Lysandr/chipwhisperer/hardware/capture/chipwhisperer-lite/pcb - guillotined/bom/CWLITEBOM.xlsx

Sheet: Change Log
Rev | Date | Line Ref | Qty Change | Note
 |  |  |  | Original Release
 | 12-24-2014 | 22 | 5 --> 4 | R37 Value Changed to 1 Ohm
 | 12-24-2014 | 20 | 3 --> 4 | R37 Value Changed to 1 Ohm
 | 12-25-2014 | 33 | 4-->5 | R77 Added (Switched Vtarget)
 | 12-25-2014 | 40 | 1-->2 | T3 Added (Switched Vtarget)
 | 12-25-2014 | 44 | 8-->7 | D8 Removed (LED Removed)
 | 12-25-2014 | 29 | 8-->7 | D8 Removed (LED Removed)
 | 01-07-2015 | 44 | 7-->4 | D4 Changed to Green, D6+D9 Changed to Blue
 | 01-07-2015 | 42 | 3-->2 | D4 Changed to Green, D7+D8 was here by error
 | 01-07-2015 | 45 | 0-->2 | D6+D9 Changed to Blue
-03 | 01-15-2015 | 39 | 1-->2 | Addition of T4
-03 | 01-15-2015 | 20 | 4-->5 | Addition of R78
-03 | 01-15-2015 | 27 | 5-->6 | Addition of R43
-04 | 03-31-2015 | 13 | 53-->52 | Deletion of C117
-04 | 03-31-2015 | 23 | 4-->3 | Deletion of R32
-04 | 03-31-2015 | 25 | 8-->9 | Addition of R79
-04 | 03-31-2015 | 13 | 52-->53 | Addition of C123 (NOTE: net effect is no change on qty of 100nF/0402)
-04 | 03-31-2015 | 29 | 7-->6 | Deletion of R38
-04 | 03-31-2015 | 53 | No Change | Change of U12 PN (XMEGA128A4U --> XMEGA128D3-AU)
-04A | 04-14-2015 | 16 | 3-->4 | Fix error in quantity
-04A | 04-14-2015 | 32 | No Change | Fix part # for resistor
-04A | 04-14-2015 | 45 | No Change | Fix missing part #
-04A | 04-14-2015 | 16 | No Change | Remove C0G dielectric spec, add part #
-04A | 04-26-2015 | 1 | 2-->3 | Fix error in quantity
-04A | 04-26-2015 | 10 | 4-->6 | Fix error in quantity
-04A | 04-28-2015 | 27 | No Change | Change R60 --> R61
-04A | 04-28-2015 | 52 | No Change | Switch Xilinx FPGA to reflect 'commercial' temp grade is OK
-04B | 04-29-2015 | 53 | No Change | Fix XMEGA Part No from D3 to D4

Sheet: BOM List
Line Ref | Qty | Open-ADC XREF Line # | Refs | Description | Value | Other Specs | Package | MPN | Digikey Part No. | Digikey Price (USD) | Extended
Capacitors, 0805
1 | 3 |  | C34, C35, C36 | Capacitor | 22uF | 10V, 20% Tol | 0805C | LMK212BJ226MG-T | 587-1958-1-ND | 0.2438 | 0.7314
2 | 1 |  | C37 | Capacitor | 47uF | 6.3V, 20% Tol | 0805C | CL21A476MQCLRNC | 1276-2420-1-ND | 0.3575 | 0.3575
Capacitors, 0603
3 | 1 |  | C33 | Capacitor | 10pF | C0G/NP0, 5% | 0603C | CL10C100JB8NCNC | 1276-2154-1-ND | 0.0138 | 0.0138
4 | 1 | 10 | C69 | Capacitor | 22pF | C0G/NP0, 5% | 0603C | CL10C220JB8NCNC | 1276-2227-1-ND | 0.0138 | 0.0138
5 | 2 |  | C87, C88 | Capacitor | 100pF | C0G/NP0, 5% | 0603C | CL10C101JB8NCNC | 1276-2163-1-ND | 0.0121 | 0.0242
6 | 3 |  | C46, C47, C104 | Capacitor | 10nF | 10V+, 10% Tol | 0603C | GRM188R71H103KA01D | 490-1512-1-ND | 0.0087 | 0.0261
7 | 1 | 7 | C67 | Capacitor | 18nF | 10V+, 10% Tol | 0603C | GRM188R71H183KA01D | 490-1516-1-ND | 0.0087 | 0.0087
8 | 11 | 4 | C41, C43, C44, C48, C49, C68, C85, C86, C106, C108, C109 | Capacitor | 100n | 10V+, 10% Tol | 0603C | GRM188R71H104KA93D | 490-1519-1-ND | 0.0182 | 0.2002
9 | 13 |  | C60, C61, C62, C63, C107, C45, C105, C78, C82, C89, C90, C110, C111 | Ceramic Capacitor | 1uF | 10V, 10% Tol | 0603C | GRM188R61A105KA61D | 490-1543-1-ND | 0.019 | 0.247
10 | 6 |  | C5, C26, C27, C38, C39, C40 | Capacitor | 2u2 | 10V, 10% Tol | 0603C | GRM188R61A225KE34D | 490-1545-1-ND | 0.0551 | 0.3306
11 | 3 |  | C3, C6, C7 | Capacitor | 4u7 | 6.3V, 10% Tol | 0603C | GRM188R60J475KE19D | 490-3297-1-ND | 0.038 | 0.114
12 | 4 |  | C42, C91, C95, C103 | Capacitor | 10uF | 10V, 10% Tol | 0603C | GRM188R61A106KE69D | 490-10474-1-ND | 0.21 | 0.84
Capacitors, 0402
13 | 53 | 1 | C4, C8, C9, C10, C11, C12, C13, C14, C15, C16, C17, C18, C19, C20, C21, C22, C23, C24, C25, C28, C29, C30, C31, C32, C52, C53, C54, C55, C56, C57, C58, C59, C64, C65, C66, C70, C71, C73, C75, C77, C79, C80, C81, C83, C92, C93, C94, C96, C98, C100, C113, C114, C123 | Capacitor | 100nF | 10V+, 10% Tol | 0402C | GRM155R61A104KA01D | 490-1318-1-ND | 0.0055 | 0.2915
14 | 2 |  | C50, C51 | Capacitor | 18pF | C0G Dielectric, 5% Tol | 0402C | C1005C0G1H180J050BA | 445-1238-1-ND | 0.011 | 0.022
15 | 3 | 2 | C72, C74, C76 | Ceramic Capacitor | 1nF | 10V+, 10% Tol | 0402C | C1005X7R1E102K050BA | 445-4924-1-ND | 0.011 | 0.033
16 | 4 | 5 | C84, C97, C99, C112 | Capacitor | 10n | 10V+, 5% tol | 0402C |  | 1276-1496-1-ND |  | 0
17 | 2 |  | C101, C102 | Capacitor | 220n | 6.3V+, 10% Tol | 0402C | LMK105BJ224KV-F | 587-1228-1-ND | 0.0248 | 0.0496
Resistors, 0805
18 | 2 |  | R66, R76 | Resistor | 49R9 |  | 0805 |  | RHM49.9AECT-ND | 0.052 | 0.104
19 | 0
Resistors, 0603
20 | 5 |  | R15, R62, R59, R37, R78 | Resistor | 1R | 1% | 0603R | MCR03ERTFL1R00 | RHM1570CT-ND | 0.0125 | 0.0625
21 | 2 | 17 | R46, R47 | Resistor | 33R | 0.50% | 0603R | RR0816Q-330-D | RR08Q33DCT-ND | 0.0381 | 0.0762
22 | 4 |  | R27, R28, R35, R36 | Resistor | 39R | 1% | 0603R | MCR03ERTF39R0 | RHM39CFCT-ND | 0.0047 | 0.0188
23 | 3 | 21 | R54, R67, R72 | Resistor | 100R | 1% | 0603R | MCR03ERTF1000 | RHM100CFCT-ND | 0.0047 | 0.0141
24 | 1 | 23 | R44 | Resistor | 274R | 0.50% | 0603R | RR0816P-2740-D-43A | RR08P274DCT-ND | 0.0381 | 0.0381
25 | 9 | 19 | R3, R7, R56, R63, R57, R58, R74, R75, R79 | Resistor | 1k | 1% | 0603R | MCR03ERTF1001 | RHM1.00KCFCT-ND | 0.0047 | 0.0423
26 | 4 | 24 | R23, R55, R52, R53 | Resistor | 2k | 1% | 0603R | MCR03ERTF2001 | RHM2.00KCFCT-ND | 0.0047 | 0.0188
27 | 6 | 20 | R13, R45, R61, R64, R65, R43 | Resistor | 10k | 1% | 0603R | MCR03ERTF1002 | RHM10.0KCFCT-ND | 0.0047 | 0.0282
Resistors, 0402
28 | 4 |  | R1, R5, R6, R14 | Resistor | 1R | 1% | 0402R |  | RHM1.00CDCT-ND | 0.0052 | 0.0208
29 | 6 |  | R2, R10, R39, R40, R41, R42 | Resistor | 330R | 1% | 0402R |  | RHM330CDCT-ND | 0.0052 | 0.0312
30 | 6 |  | R16, R48, R49, R50, R51, R68 | Resistor | 1k | 1% | 0402R |  | RHM1.00KCDCT-ND | 0.0052 | 0.0312
31 | 3 |  | R24, R26, R30 | Resistor | 1.5k | 1% | 0402R |  | RHM1.50KCDCT-ND | 0.0052 | 0.0156
32 | 2 |  | R25, R29 | Resistor | 6.81k | 1% | 0402R |  | 1276-4099-1-ND | 0.0052 | 0.0104
33 | 5 |  | R9, R11, R12, R69, R77 | Resistor | 10k | 1% | 0402R |  | RHM10.0KCDCT-ND | 0.0052 | 0.026
34 | 1 |  | R33 | Resistor | 47k | 1% | 0402R |  | RHM47.0KCDCT-ND | 0.0052 | 0.0052
35 | 1 |  | R34 | Resistor | 68k | 1% | 0402R |  | RHM68KCDCT-ND | 0.0052 | 0.0052
36 | 6 |  | R17, R18, R19, R20, R21, R31 | Resistor | 100k | 1% | 0402R |  | RHM100KCDCT-ND | 0.0052 | 0.0312
Diodes, Transistors
37 | 1 | 35 | D1 | Dual Diode | BAV99-7F |  | SOT-23 | BAV99-7-F | BAV99-FDICT-ND | 0.0927 | 0.0927
38 | 1 |  | U8 | N-Channel MOSFET | IRF7807ZTRPBF |  | SO08 | IRF7807ZTRPBF | IRF7807ZPBFCT-ND | 0.4607 | 0.4607
39 | 2 |  | T2,T4 | N-Channel MOSFET | IRLML2502 |  | SOT-23 | IRLML2502TRPBF | IRLML2502PBFCT-ND | 0.1441 | 0.2882
40 | 2 |  | T1,T3 | P-Channel MOSFET | IRLML6402TRPBF |  | SOT-23 | IRLML6402TRPBF | IRLML6402PBFCT-ND | 0.1333 | 0.2666
41 | 1 |  | U6 | ESD Protection Diode | PRTR5V0U2AX |  | SOT143B | PRTR5V0U2AX,215 | 568-7445-1-ND | 0.3634 | 0.3634
LEDs, 0603
42 | 2 |  | D4, LED9 | Green LED |  |  | LED-0603 | APT1608CGCK | 754-1116-1-ND | 0.1346 | 0.2692
43 | 0 |  |  | Yellow LED |  |  | LED-0603 |  |  |  | 0
44 | 4 |  | D2, D5, D7, LED10 | Red LED |  |  | LED-0603 | APT1608SURCK | 754-1123-1-ND | 0.1228 | 0.4912
45 | 2 |  | D6, D9 | Blue LED |  |  | LED-0603 | APT1608QBC/D | 754-1434-2-ND |  | 0
Inductors, Ferrite Bead
46 | 1 |  | L1 | Inductor | 10uH/100mA |  | 0603 |  | 535-12537-1-ND | 0.2925 | 0.2925
47 | 1 | 16 | L11 | Inductor | 120nH |  | 0603 |  | HK1005R12J-T | 0.0175 | 0.0175
48 | 5 | ? | L5, L7, L8, L9, L10 | Ferrite bead | 1k/500mA |  | 0603 |  | 587-1739-1-ND | 0.0508 | 0.254
49 | 2 |  | L4, L6 | Ferrite bead | 600R/1A |  | 0603 |  | 732-1593-1-ND | 0.1725 | 0.345
50 | 2 |  | L2, L3 | Shielded Inductor, Power | 3.3uH |  | VLS3015 | SRN3015-3R3M | SRN3015-3R3MCT-ND | 0.36 | 0.72 | SUB: VLS3015ET-3R3M
Crystals
51 | 1 |  | Q1 | Crystal | 12.0000MHz |  | 3.2 x 2.5mm | ABM8G-12.000MHZ-4Y-T3 | 535-10901-1-ND | 0.54 | 0.54
IC's
52 | 1 |  | U2 | Xilinx FPGA | 6SLX9TQG144 | Must be -3, NOT -2 | TQ144 | XC6SLX9-3TQG144C | 122-1748-ND | 19.82 | 19.82
53 | 1 |  | U12 | XMEGA Microcontroller | XMEGA128D4-AU |  | TQFP44 | XMEGA128D4-AU | ATXMEGA128D4-AURCT-ND | 3.51 | 3.51
54 | 1 |  | U1 | SAM3S Microcontroller | ATSAM3U2CA-AU |  | QFP50P1600X1600X160-100N | ATSAM3U2CA-AU | ATSAM3U2CA-AU-ND | 4.6531 | 4.6531
55 | 1 | 31 | U3 | Analog Devices VGA | AD8331 |  | QSOP20 | AD8331ARQZ | AD8331ARQZ-R7CT-ND | 9.0606 | 9.0606
56 | 1 | 30 | U4 | Analog Devices ADC | AD9215BRUZ |  | TSSOP28 | AD9215BRUZ-105 | AD9215BRUZ-105-ND | 12.2579 | 12.2579
57 | 1 | 32 | U10 | LDO Regulator, 3.0V | LP3985IM5-3.0 |  | SOT23-5 | LP3985IM5X-3.0/NOPB | LP3985IM5X-3.0/NOPBCT-ND | 0.4253 | 0.4253
58 | 1 |  | U7 | LDO Regulator, 3.3V | TC1262-3.3VDBTR |  | SOT223 | TC1262-3.3VDBTR | TC1262-3.3VDBCT-ND | 0.39 | 0.39
59 | 1 |  | U5 | Switching Regulator | LTC3419EMS |  | MSOP10 | LTC3419EMS#PBF | LTC3419EMS#PBF-ND | 2.29 | 2.29
Connectors
60 | 1 |  | J8 | Micro-USB jack, through-hole | MICRO-USB-5P-ZX62D-B-5P8 |  | B-SMD-5P-TH | ZX62D-B-5P8 | H11610CT-ND | 0.9133 | 0.9133
 |  |  |  |  |  |  |  |  |  |  | 61.6044
