Lysandr/chipwhisperer/hardware/capture/chipwhisperer-lite/pcb - guillotined/eagle/cw-lite-main.brd

## EAGLE design hardware/capture/chipwhisperer-lite/pcb - guillotined/eagle/cw-lite-main.brd (2020-10-10)

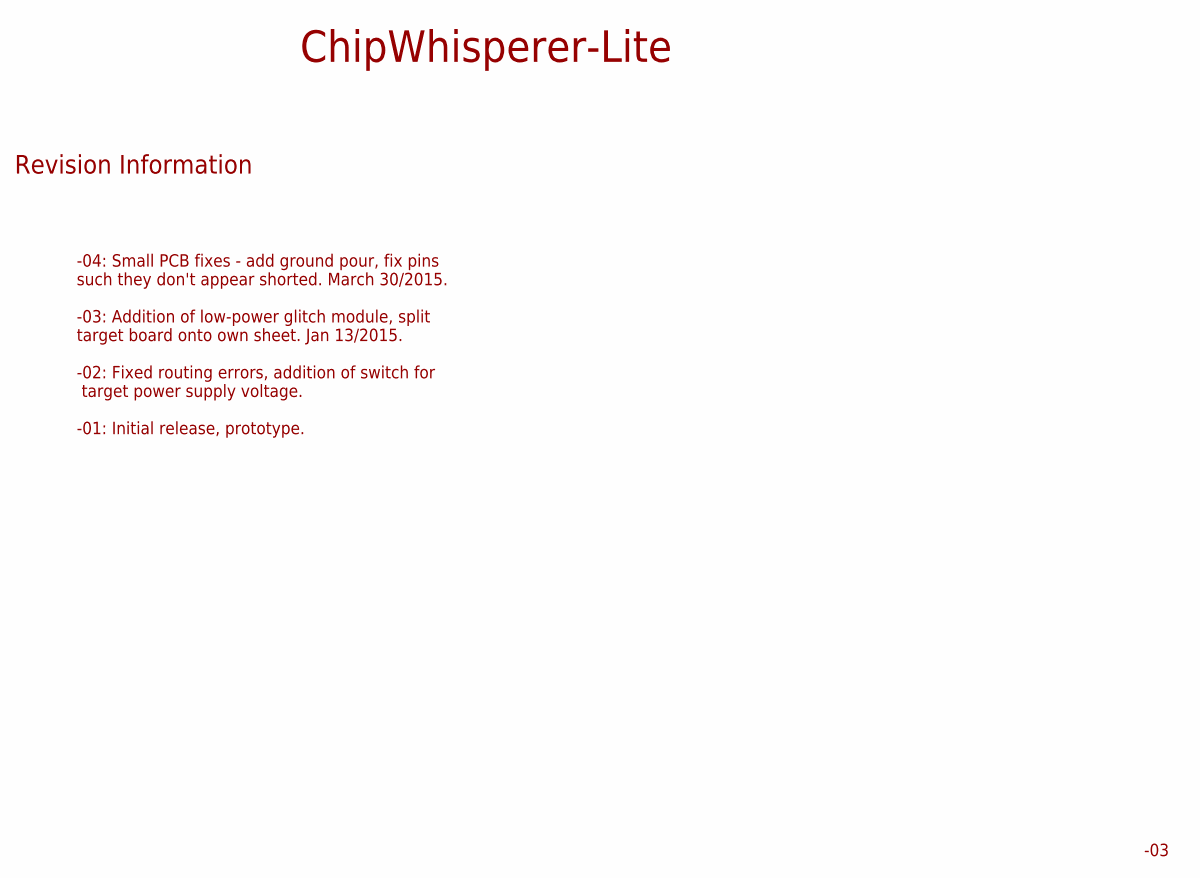
[picture p1: schematic cw-lite-main.sch, sheet 1]

Notes on the sheet:
-04: Small PCB fixes - add ground pour, fix pins such they don't appear shorted. March 30/2015. -03: Addition of low-power glitch module, split target board onto own sheet. Jan 13/2015. -02: Fixed routing errors, addition of switch for target power supply voltage. -01: Initial release, prototype.
ChipWhisperer-Lite
Revision Information

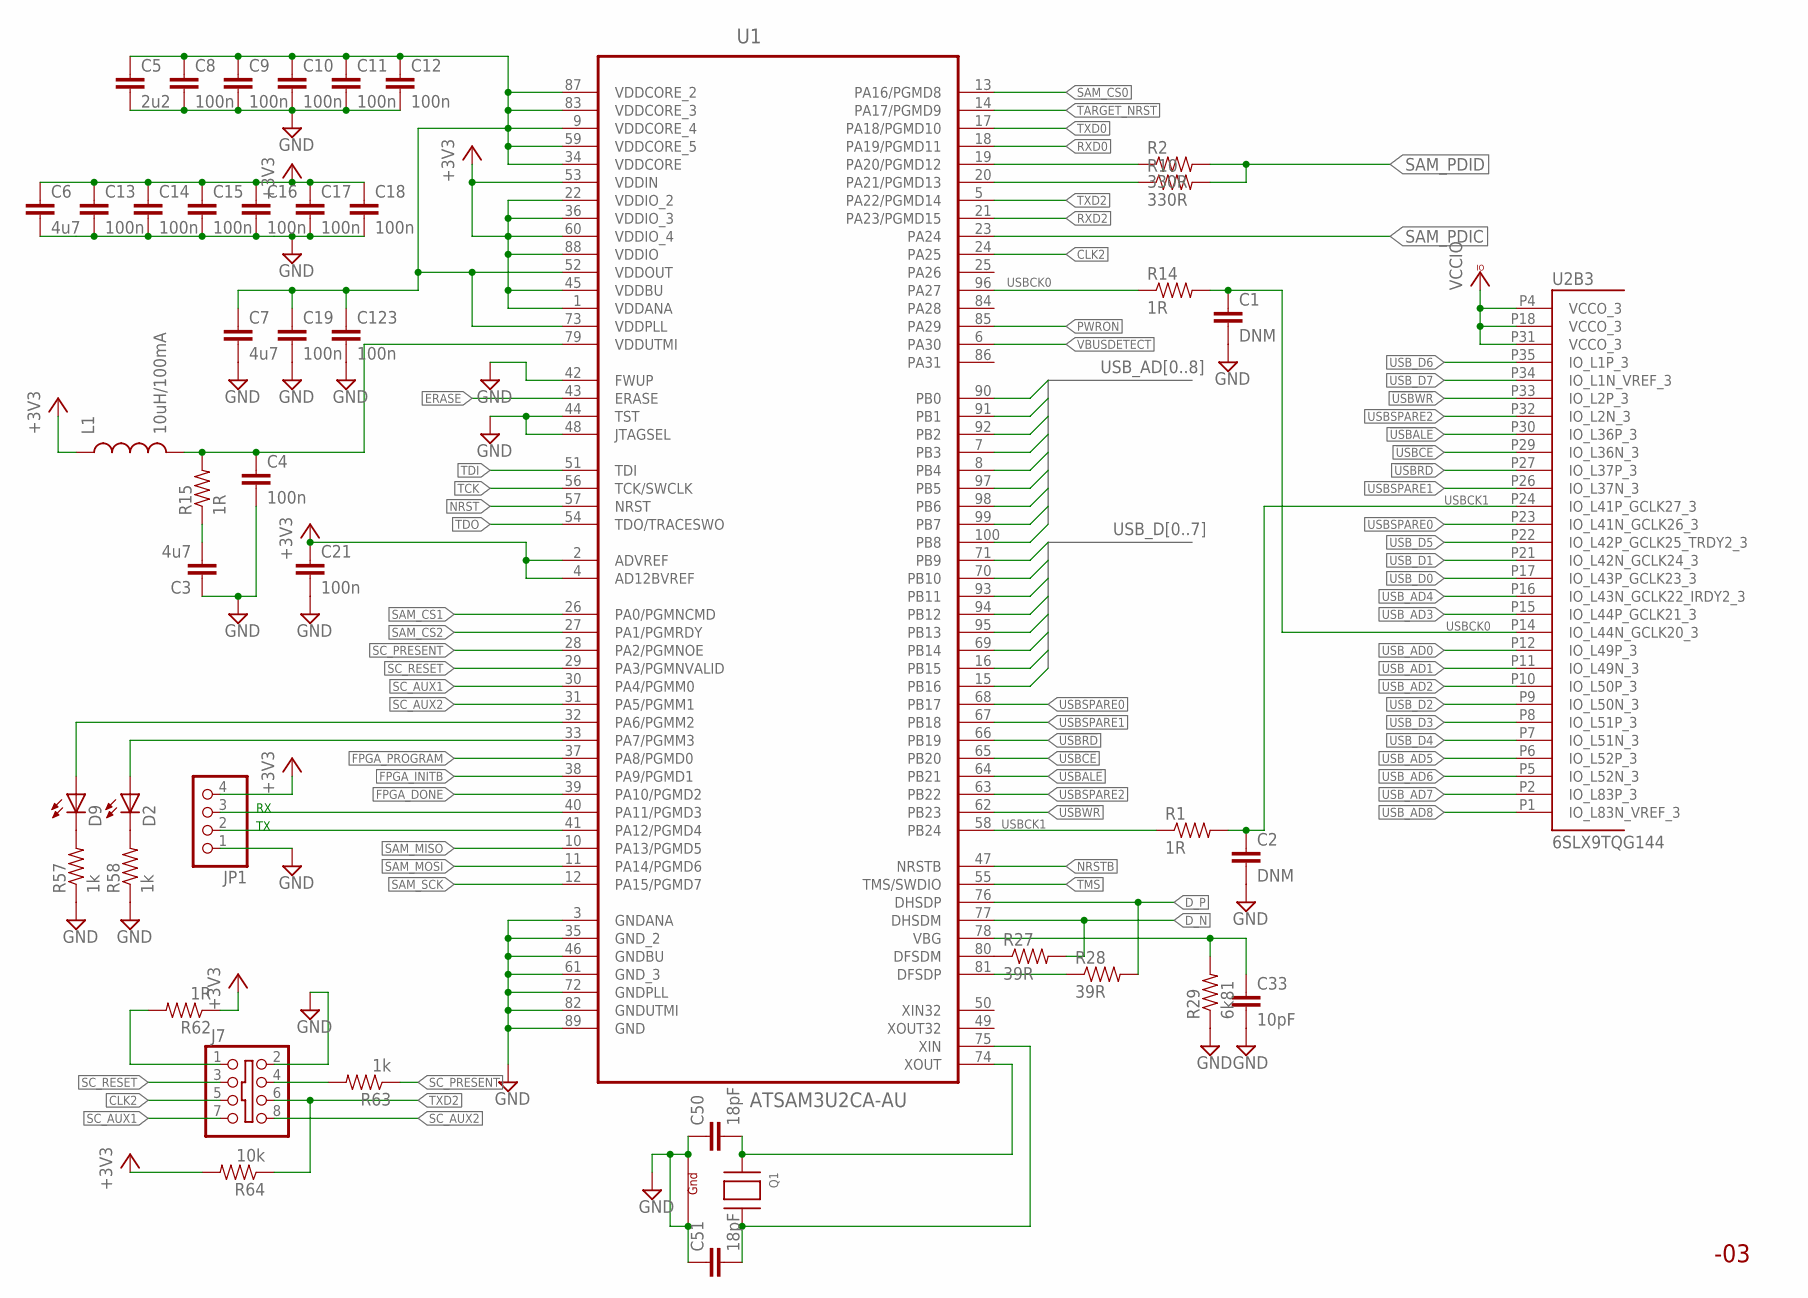
[picture p2: schematic cw-lite-main.sch, sheet 2]

Parts:
C1, C2: DNM; 0402C
C3, C6, C7: 4u7; 0603C
C4, C8, C9, C10, C11, C12, C13, C14, C15, C16, C17, C18, C19, C21, C123: 100n; 0402C
C5: 2u2; 0603C
C33: 10pF; 0603C
C50, C51: 18pF; 0402C
D2, D9: LED0603; LED-0603
J7: SHROUD_2X4EDGE; PINSHRD_EDGE_2X04.PAC
JP1: PINHD-1X4; 1X04
L1: 10uH/100mA; 0603
Q1: XTAL-4ABM8G; NX3225; MPN ABM8G-12.000MHZ-4Y-T3
R1, R14: 1R; 0402R
R2, R10: 330R; 0402R
R15, R62: 1R; 0603R
R27, R28: 39R; 0603R
R29: 6k81; 0402R
R57, R58, R63: 1k; 0603R
R64: 10k; 0603R
U1: ATSAM3U2CA-AU; QFP50P1600X1600X160-100N
U2: 6SLX9TQG144; TQ144; MPN XC6SLX9-3TQG144C

Connections:
!USBALE: U1.64 (PB21), U2.P30 (IO_L36P_3)
!USBCE: U1.65 (PB20), U2.P29 (IO_L36N_3)
!USBRD: U1.66 (PB19), U2.P27 (IO_L37P_3)
!USBWR: U1.62 (PB23), U2.P33 (IO_L2P_3)
+3V3: C6.1, C13.1, C14.1, C15.1, C16.1, C17.1, C18.1, C21.1, JP1.4, L1.1, R62.1, R64.2, U1.1 (VDDANA), U1.2 (ADVREF), U1.4 (AD12BVREF), U1.22 (VDDIO_2), U1.36 (VDDIO_3), U1.45 (VDDBU), U1.53 (VDDIN), U1.60 (VDDIO_4), U1.88 (VDDIO); also elsewhere on the board
CLK2: J7.5, U1.24 (PA25); also elsewhere on the board
D_N: R27.2, U1.77 (DHSDM); also elsewhere on the board
D_P: R28.2, U1.76 (DHSDP); also elsewhere on the board
ERASE: U1.43 (ERASE); also elsewhere on the board
FPGA_DONE: U1.39 (PA10/PGMD2); also elsewhere on the board
FPGA_INITB: U1.38 (PA9/PGMD1); also elsewhere on the board
FPGA_PROGRAM: U1.37 (PA8/PGMD0); also elsewhere on the board
GND: C1.2, C2.2, C3.1, C4.2, C5.2, C6.2, C7.2, C8.2, C9.2, C10.2, C11.2, C12.2, C13.2, C14.2, C15.2, C16.2, C17.2, C18.2, C19.2, C21.2, C33.2, C50.1, C51.1, C123.2, J7.2, JP1.1, Q1.2 (G1), Q1.4 (G2), R29.1, R57.1, R58.1, U1.3 (GNDANA), U1.35 (GND_2), U1.42 (FWUP), U1.44 (TST), U1.46 (GNDBU), U1.48 (JTAGSEL), U1.61 (GND_3), U1.72 (GNDPLL), U1.82 (GNDUTMI), U1.89 (GND); also elsewhere on the board
unnamed: R14.1, U1.96 (PA27)
unnamed: JP1.3, U1.40 (PA11/PGMD3)
unnamed: R1.1, U1.58 (PB24)
unnamed: JP1.2, U1.41 (PA12/PGMD4)
unnamed: R2.1, U1.19 (PA20/PGMD12)
unnamed: R10.1, U1.20 (PA21/PGMD13)
unnamed: C3.2, R15.1
unnamed: C4.1, L1.2, R15.2, U1.79 (VDDUTMI)
unnamed: R27.1, U1.80 (DFSDM)
unnamed: C5.1, C7.1, C8.1, C9.1, C10.1, C11.1, C12.1, C19.1, C123.1, U1.9 (VDDCORE_4), U1.34 (VDDCORE), U1.52 (VDDOUT), U1.59 (VDDCORE_5), U1.73 (VDDPLL), U1.83 (VDDCORE_3), U1.87 (VDDCORE_2)
unnamed: R28.1, U1.81 (DFSDP)
unnamed: C33.1, R29.2, U1.78 (VBG)
unnamed: C51.2, Q1.3 (X2), U1.75 (XIN)
unnamed: C50.2, Q1.1 (X1), U1.74 (XOUT)
unnamed: D9.A, U1.32 (PA6/PGMM2)
unnamed: D2.A, U1.33 (PA7/PGMM3)
unnamed: D9.C, R57.2
unnamed: D2.C, R58.2
unnamed: J7.1, R62.2
unnamed: J7.4, R63.2
NRST: U1.57 (NRST); also elsewhere on the board
NRSTB: U1.47 (NRSTB); also elsewhere on the board
PWRON: U1.85 (PA29); also elsewhere on the board
RXD0: U1.18 (PA19/PGMD11); also elsewhere on the board
RXD2: U1.21 (PA23/PGMD15); also elsewhere on the board
SAM_CS0: U1.13 (PA16/PGMD8); also elsewhere on the board
SAM_CS1: U1.26 (PA0/PGMNCMD); also elsewhere on the board
SAM_CS2: U1.27 (PA1/PGMRDY)
SAM_MISO: U1.10 (PA13/PGMD5); also elsewhere on the board
SAM_MOSI: U1.11 (PA14/PGMD6); also elsewhere on the board
SAM_PDIC: U1.23 (PA24); also elsewhere on the board
SAM_PDID: R2.2, R10.2; also elsewhere on the board
SAM_SCK: U1.12 (PA15/PGMD7); also elsewhere on the board
SC_AUX1: J7.7, U1.30 (PA4/PGMM0); also elsewhere on the board
SC_AUX2: J7.8, U1.31 (PA5/PGMM1); also elsewhere on the board
SC_PRESENT: R63.1, U1.28 (PA2/PGMNOE)
SC_RESET: J7.3, U1.29 (PA3/PGMNVALID); also elsewhere on the board
TARGET_NRST: U1.14 (PA17/PGMD9); also elsewhere on the board
TCK: U1.56 (TCK/SWCLK); also elsewhere on the board
TDI: U1.51 (TDI); also elsewhere on the board
TDO: U1.54 (TDO/TRACESWO); also elsewhere on the board
TMS: U1.55 (TMS/SWDIO); also elsewhere on the board
TXD0: U1.17 (PA18/PGMD10); also elsewhere on the board
TXD2: J7.6, R64.1, U1.5 (PA22/PGMD14); also elsewhere on the board
USBCK0: C1.1, R14.2, U2.P14 (IO_L44N_GCLK20_3)
USBCK1: C2.1, R1.2, U2.P24 (IO_L41P_GCLK27_3)
USBSPARE0: U1.68 (PB17), U2.P23 (IO_L41N_GCLK26_3)
USBSPARE1: U1.67 (PB18), U2.P26 (IO_L37N_3)
USBSPARE2: U1.63 (PB22), U2.P32 (IO_L2N_3)
USB_AD0: U1.90 (PB0), U2.P12 (IO_L49P_3)
USB_AD1: U1.91 (PB1), U2.P11 (IO_L49N_3)
USB_AD2: U1.92 (PB2), U2.P10 (IO_L50P_3)
USB_AD3: U1.7 (PB3), U2.P15 (IO_L44P_GCLK21_3)
USB_AD4: U1.8 (PB4), U2.P16 (IO_L43N_GCLK22_IRDY2_3)
USB_AD5: U1.97 (PB5), U2.P6 (IO_L52P_3)
USB_AD6: U1.98 (PB6), U2.P5 (IO_L52N_3)
USB_AD7: U1.99 (PB7), U2.P2 (IO_L83P_3)
USB_AD8: U1.100 (PB8), U2.P1 (IO_L83N_VREF_3)
USB_D0: U1.71 (PB9), U2.P17 (IO_L43P_GCLK23_3)
USB_D1: U1.70 (PB10), U2.P21 (IO_L42N_GCLK24_3)
USB_D2: U1.93 (PB11), U2.P9 (IO_L50N_3)
USB_D3: U1.94 (PB12), U2.P8 (IO_L51P_3)
USB_D4: U1.95 (PB13), U2.P7 (IO_L51N_3)
USB_D5: U1.69 (PB14), U2.P22 (IO_L42P_GCLK25_TRDY2_3)
USB_D6: U1.16 (PB15), U2.P35 (IO_L1P_3)
USB_D7: U1.15 (PB16), U2.P34 (IO_L1N_VREF_3)
VBUSDETECT: U1.6 (PA30); also elsewhere on the board
VCCIO: U2.P4 (VCCO_3), U2.P18 (VCCO_3), U2.P31 (VCCO_3); also elsewhere on the board

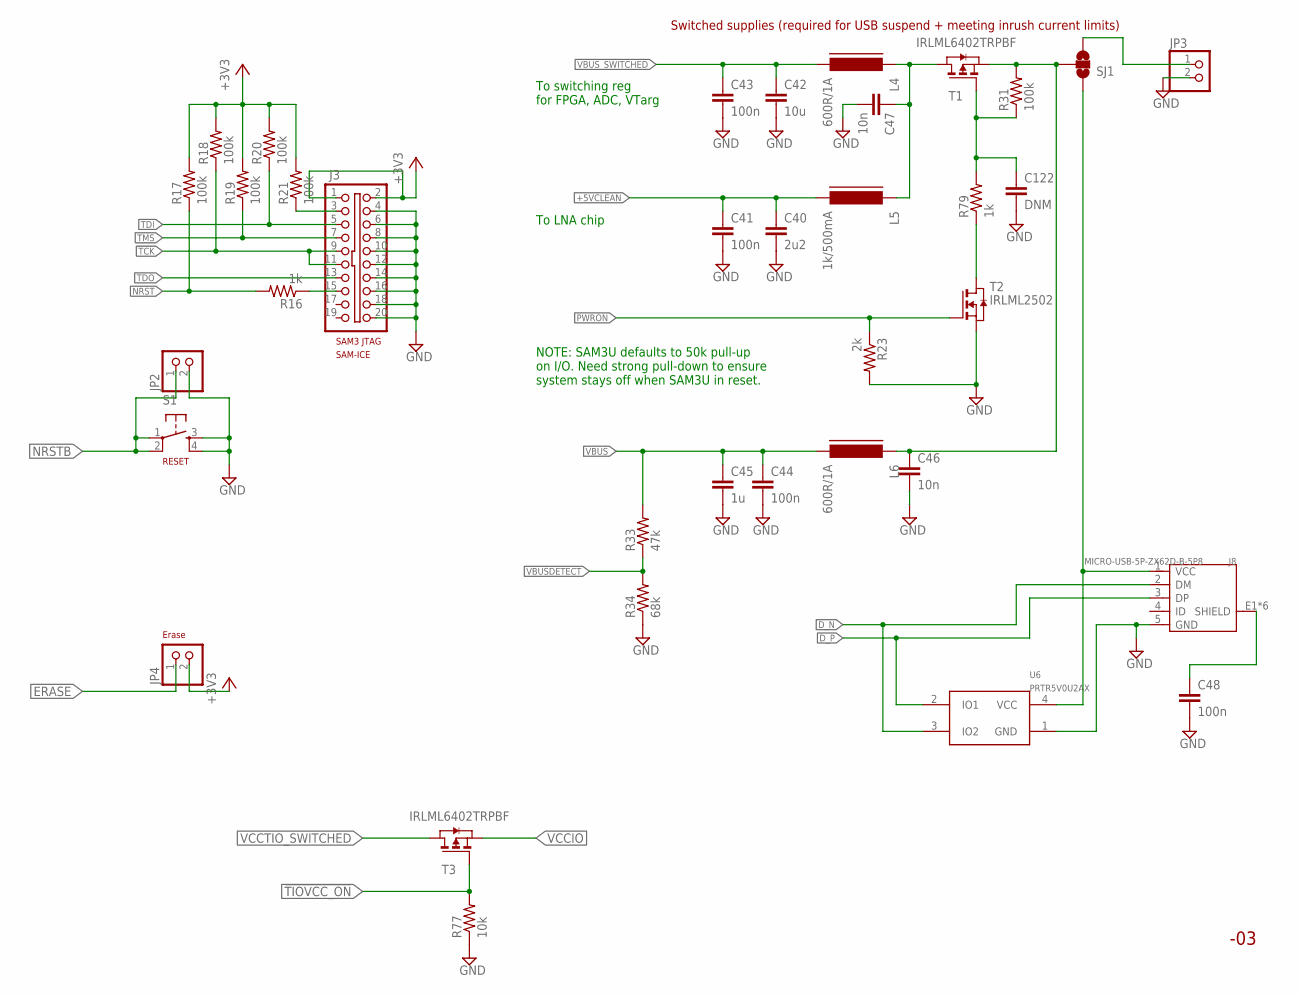
[picture p3: schematic cw-lite-main.sch, sheet 3]

Parts:
C40: 2u2; 0603C
C41, C43, C44, C48: 100n; 0603C
C42: 10u; 0603C
C45: 1u; 0603C
C46, C47: 10n; 0603C
C122: DNM; 0603C
J3: SHROUD_2X10-SHROUDED; PINSHRD_PTH_2X10
J8: MICRO-USB-5P-ZX62D-B-5P8; B-SMD-5P-TH; MPN ZX62D-B-5P8
JP2, JP3, JP4: PINHD-1X2; 1X02
L4, L6: 600R/1A; FB603
L5: 1k/500mA; FB603
R16: 1k; 0402R
R17, R18, R19, R20, R21, R31: 100k; 0402R
R23: 2k; 0603R
R33: 47k; 0402R
R34: 68k; 0402R
R77: 10k; 0402R
R79: 1k; 0603R
S1: TAC_SWITCHSMD; TACTILE_SWITCH_SMD
SJ1: SOLDERJUMPER_2WAYPASTE1&2; SJ_3_PASTE1&2
T1, T3: IRLML6402TRPBF; SOT-23; MPN IRLML6402TRPBF
T2: IRLML2502; SOT-23; MPN IRLML2502TRPBF
U6: PRTR5V0U2AX; SOT143B; MPN PRTR5V0U2AX,215

Connections:
!TIOVCC_ON: R77.2, T3.3 (G); also elsewhere on the board
+3V3: J3.1, J3.2, JP4.2, R17.2, R18.2, R19.2, R20.2, R21.2; also elsewhere on the board
+5VCLEAN: C40.1, C41.1, L5.2; also elsewhere on the board
D_N: J8.2 (DM), U6.3 (IO2); also elsewhere on the board
D_P: J8.3 (DP), U6.2 (IO1); also elsewhere on the board
ERASE: JP4.1; also elsewhere on the board
GND: C40.2, C41.2, C42.2, C43.2, C44.2, C45.2, C46.2, C47.2, C48.2, C122.2, J3.4, J3.6, J3.8, J3.10, J3.12, J3.14, J3.16, J3.18, J3.20, J8.5 (GND), JP2.2, JP3.2, R23.2, R34.1, R77.1, S1.3, S1.4, T2.2 (S), U6.1 (GND); also elsewhere on the board
unnamed: J3.3, R21.1
unnamed: J3.15, R16.1
unnamed: JP3.1, SJ1.3
unnamed: C46.1, L6.1, R31.2, SJ1.2, T1.2 (S)
unnamed: J8.1 (VCC), SJ1.1, U6.4 (VCC)
unnamed: C47.1, L4.1, L5.1, T1.1 (D)
unnamed: C122.1, R31.1, R79.2, T1.3 (G)
unnamed: R79.1, T2.1 (D)
unnamed: C48.1, J8.E1 (SHIELD), J8.E2 (SHIELD), J8.P$1 (SHIELD), J8.P$2 (SHIELD), J8.P$3 (SHIELD), J8.P$4 (SHIELD)
NRST: R16.2, R17.1; also elsewhere on the board
NRSTB: JP2.1, S1.1, S1.2; also elsewhere on the board
PWRON: R23.1, T2.3 (G); also elsewhere on the board
TCK: J3.9, J3.11, R18.1; also elsewhere on the board
TDI: J3.5, R20.1; also elsewhere on the board
TDO: J3.13; also elsewhere on the board
TMS: J3.7, R19.1; also elsewhere on the board
VBUS: C44.1, C45.1, L6.2, R33.2; also elsewhere on the board
VBUSDETECT: R33.1, R34.2; also elsewhere on the board
VBUS_SWITCHED: C42.1, C43.1, L4.2; also elsewhere on the board
VCCIO: T3.2 (S); also elsewhere on the board
VCCTIO_SWITCHED: T3.1 (D); also elsewhere on the board

Notes on the sheet:
SAM3 JTAG
SAM-ICE
RESET
Erase
Switched supplies (required for USB suspend + meeting inrush current limits)
NOTE: SAM3U defaults to 50k pull-up on I/O. Need strong pull-down to ensure system stays off when SAM3U in reset.
To switching reg for FPGA, ADC, VTarg
To LNA chip

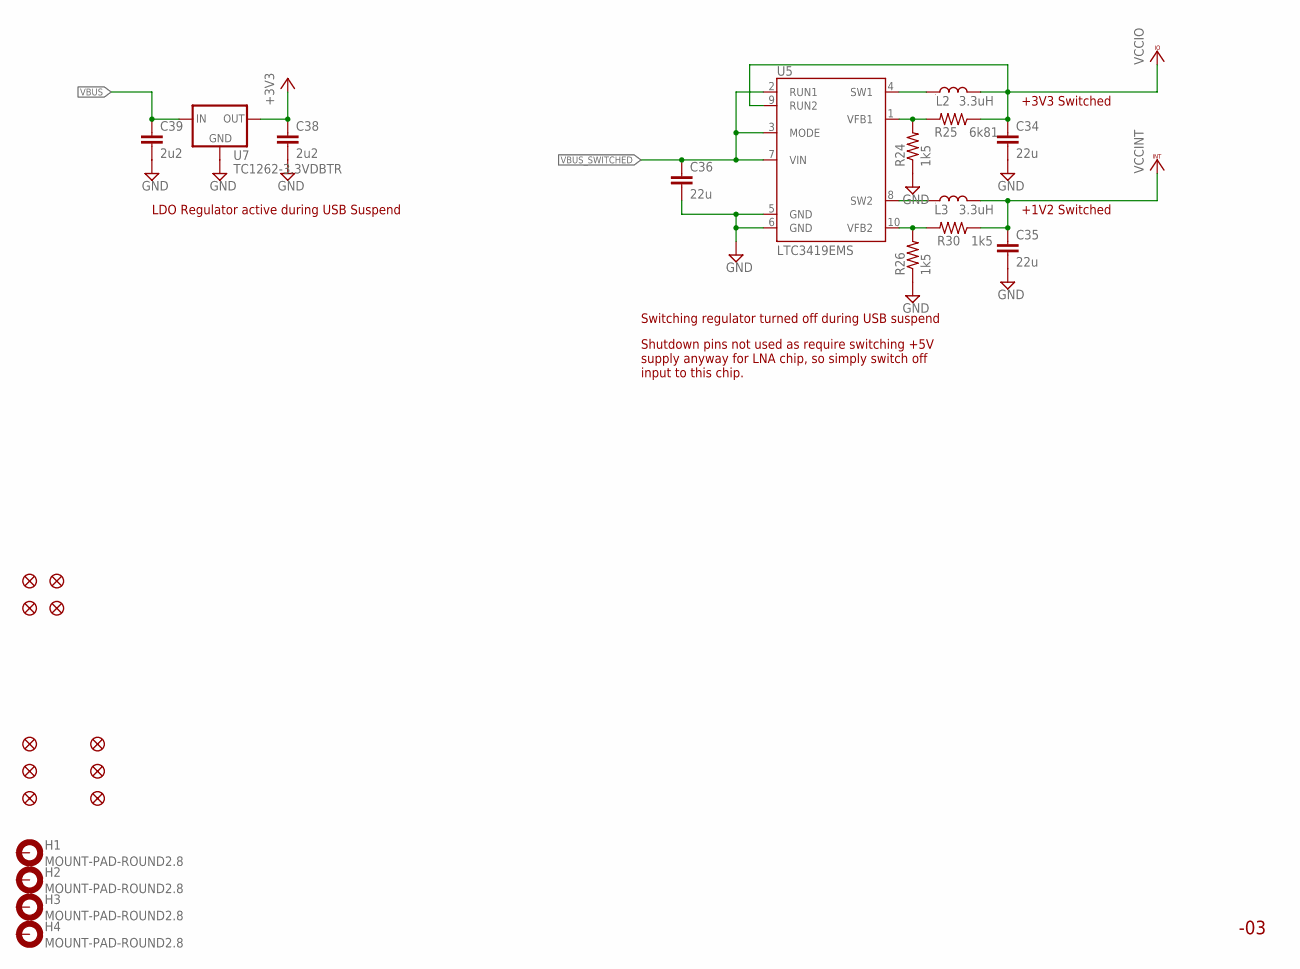
[picture p4: schematic cw-lite-main.sch, sheet 4]

Parts:
C34, C35, C36: 22u; 0805
C38, C39: 2u2; 0603C
FID1, FID2, FID3, FID4, FID5, FID6: FIDUCIAL1.5X3; FIDUCIAL-1.5X3
H1, H2, H3, H4: MOUNT-PAD-ROUND2.8; 2,8-PAD
L2: 3.3uH; VLS3015
L3: 3.3uH; VLS3015; MPN VLS3015ET-3R3M
MFID1, MFID2, MFID3, MFID4: FIDUCIALUFIDUCIAL; MICRO-FIDUCIAL
R24, R26, R30: 1k5; 0402R
R25: 6k81; 0402R
U5: LTC3419EMS; MSOP10; MPN LTC3419EMS#PBF
U7: TC1262-3.3VDBTR; SOT223; MPN TC1262-3.3VDBTR

Connections:
+3V3: C38.1, U7.3 (OUT); also elsewhere on the board
FB_1V2: R26.2, R30.2, U5.10 (VFB2)
FB_3V3: R24.2, R25.2, U5.1 (VFB1)
GND: C34.2, C35.2, C36.2, C38.2, C39.2, R24.1, R26.1, U5.5 (GND), U5.6 (GND), U7.2 (GND); also elsewhere on the board
unnamed: L2.1, U5.4 (SW1)
unnamed: L3.1, U5.8 (SW2)
VBUS: C39.1, U7.1 (IN); also elsewhere on the board
VBUS_SWITCHED: C36.1, U5.2 (RUN1), U5.3 (MODE), U5.7 (VIN); also elsewhere on the board
VCCINT: C35.1, L3.2, R30.1; also elsewhere on the board
VCCIO: C34.1, L2.2, R25.1, U5.9 (RUN2); also elsewhere on the board

Notes on the sheet:
+3V3 Switched
+1V2 Switched
LDO Regulator active during USB Suspend
Switching regulator turned off during USB suspend
Shutdown pins not used as require switching +5V supply anyway for LNA chip, so simply switch off input to this chip.

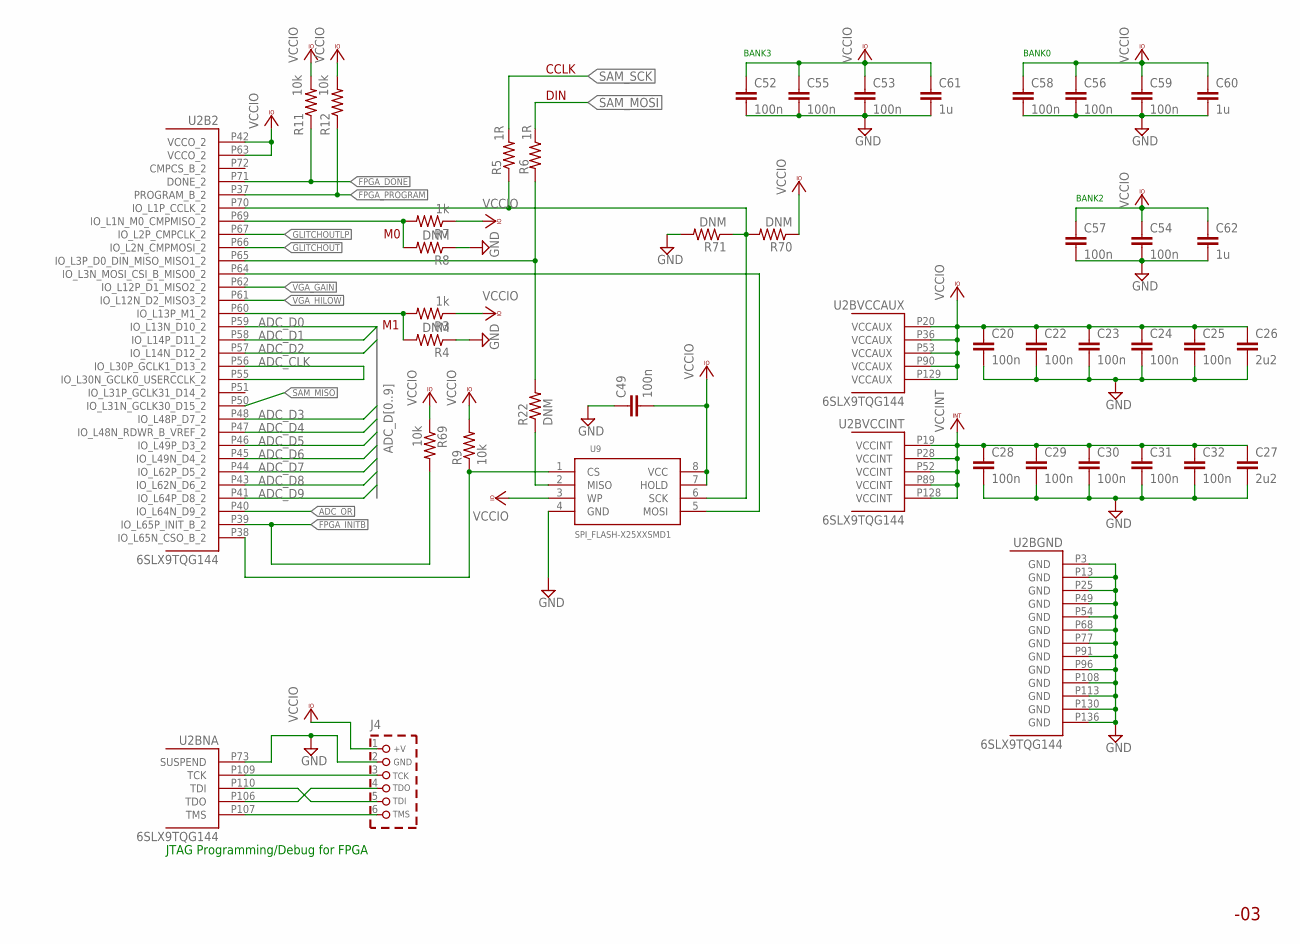
[picture p5: schematic cw-lite-main.sch, sheet 5]

Parts:
C20, C22, C23, C24, C25, C28, C29, C30, C31, C32, C52, C53, C54, C55, C56, C57, C58, C59: 100n; 0402C
C26, C27: 2u2; 0603C
C49: 100n; 0603C
C60, C61, C62: 1u; 0603C
J4: CON_HEADER_PRG_XILINX_JTAG6; HEADER_PRG_1X06
R3, R7: 1k; 0603R
R4, R8, R22: DNM; 0603R
R5, R6: 1R; 0402R
R9, R11, R12, R69: 10k; 0402R
R70, R71: DNM; 0402R
U2: 6SLX9TQG144; TQ144; MPN XC6SLX9-3TQG144C
U9: SPI_FLASH-X25XXSMD1; SO08-EIAJ

Connections:
ADC_CLK: U2.P55 (IO_L30N_GCLK0_USERCCLK_2), U2.P56 (IO_L30P_GCLK1_D13_2); also elsewhere on the board
ADC_D0: U2.P59 (IO_L13N_D10_2); also elsewhere on the board
ADC_D1: U2.P58 (IO_L14P_D11_2); also elsewhere on the board
ADC_D2: U2.P57 (IO_L14N_D12_2); also elsewhere on the board
ADC_D3: U2.P48 (IO_L48P_D7_2); also elsewhere on the board
ADC_D4: U2.P47 (IO_L48N_RDWR_B_VREF_2); also elsewhere on the board
ADC_D5: U2.P46 (IO_L49P_D3_2); also elsewhere on the board
ADC_D6: U2.P45 (IO_L49N_D4_2); also elsewhere on the board
ADC_D7: U2.P44 (IO_L62P_D5_2); also elsewhere on the board
ADC_D8: U2.P43 (IO_L62N_D6_2); also elsewhere on the board
ADC_D9: U2.P41 (IO_L64P_D8_2); also elsewhere on the board
ADC_OR: U2.P40 (IO_L64N_D9_2); also elsewhere on the board
FPGA_DONE: R11.1, U2.P71 (DONE_2); also elsewhere on the board
FPGA_INITB: R69.2, U2.P39 (IO_L65P_INIT_B_2); also elsewhere on the board
FPGA_PROGRAM: R12.1, U2.P37 (PROGRAM_B_2); also elsewhere on the board
GLITCHOUT: U2.P66 (IO_L2N_CMPMOSI_2); also elsewhere on the board
GLITCHOUTLP: U2.P67 (IO_L2P_CMPCLK_2); also elsewhere on the board
GND: C20.2, C22.2, C23.2, C24.2, C25.2, C26.2, C27.2, C28.2, C29.2, C30.2, C31.2, C32.2, C49.1, C52.2, C53.2, C54.2, C55.2, C56.2, C57.2, C58.2, C59.2, C60.2, C61.2, C62.2, J4.2 (GND), R4.1, R8.1, R71.2, U2.P3 (GND), U2.P13 (GND), U2.P25 (GND), U2.P49 (GND), U2.P54 (GND), U2.P68 (GND), U2.P73 (SUSPEND), U2.P77 (GND), U2.P91 (GND), U2.P96 (GND), U2.P108 (GND), U2.P113 (GND), U2.P130 (GND), U2.P136 (GND), U9.4 (GND); also elsewhere on the board
unnamed: R5.1, R70.2, R71.1, U2.P70 (IO_L1P_CCLK_2), U9.6 (SCK)
unnamed: R9.1, U2.P38 (IO_L65N_CSO_B_2), U9.1 (CS)
unnamed: R3.2, R4.2, U2.P60 (IO_L13P_M1_2)
unnamed: R7.2, R8.2, U2.P69 (IO_L1N_M0_CMPMISO_2)
unnamed: U2.P64 (IO_L3N_MOSI_CSI_B_MISO0_2), U9.5 (MOSI)
unnamed: R6.2, R22.2, U2.P65 (IO_L3P_D0_DIN_MISO_MISO1_2)
unnamed: R22.1, U9.2 (MISO)
unnamed: J4.6 (TMS), U2.P107 (TMS)
unnamed: J4.5 (TDI), U2.P110 (TDI)
unnamed: J4.4 (TDO), U2.P106 (TDO)
unnamed: J4.3 (TCK), U2.P109 (TCK)
SAM_MISO: U2.P50 (IO_L31N_GCLK30_D15_2); also elsewhere on the board
SAM_MOSI: R6.1; also elsewhere on the board
SAM_SCK: R5.2; also elsewhere on the board
VCCINT: C27.1, C28.1, C29.1, C30.1, C31.1, C32.1, U2.P19 (VCCINT), U2.P28 (VCCINT), U2.P52 (VCCINT), U2.P89 (VCCINT), U2.P128 (VCCINT); also elsewhere on the board
VCCIO: C20.1, C22.1, C23.1, C24.1, C25.1, C26.1, C49.2, C52.1, C53.1, C54.1, C55.1, C56.1, C57.1, C58.1, C59.1, C60.1, C61.1, C62.1, J4.1 (+V), R3.1, R7.1, R9.2, R11.2, R12.2, R69.1, R70.1, U2.P20 (VCCAUX), U2.P36 (VCCAUX), U2.P42 (VCCO_2), U2.P53 (VCCAUX), U2.P63 (VCCO_2), U2.P90 (VCCAUX), U2.P129 (VCCAUX), U9.3 (WP), U9.7 (HOLD), U9.8 (VCC); also elsewhere on the board
VGA_GAIN: U2.P62 (IO_L12P_D1_MISO2_2); also elsewhere on the board
VGA_HILOW: U2.P61 (IO_L12N_D2_MISO3_2); also elsewhere on the board

Notes on the sheet:
BANK2
BANK3
BANK0
CCLK
DIN
JTAG Programming/Debug for FPGA

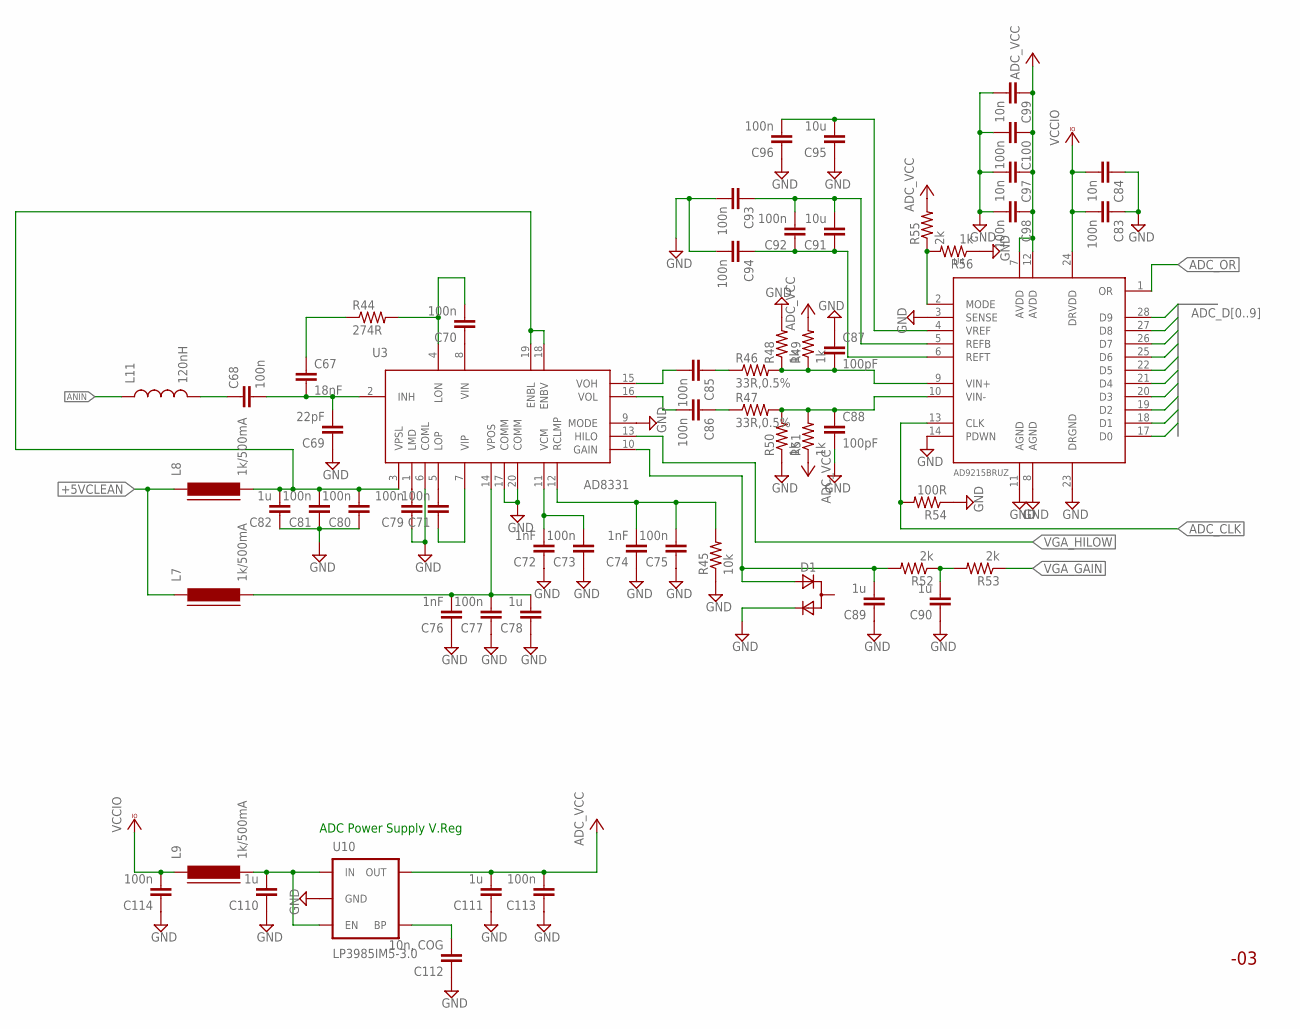
[picture p6: schematic cw-lite-main.sch, sheet 6]

Parts:
C67: 18nF; 0603C
C68, C85, C86: 100n; 0603C
C69: 22pF; 0603C
C70, C71, C73, C75, C77, C79, C80, C81, C83, C92, C93, C94, C96, C98, C100, C113, C114: 100n; 0402C
C72, C74, C76: 1nF; 0402C
C78, C82, C89, C90, C110, C111: 1u; 0603C
C84, C97, C99: 10n; 0402C
C87, C88: 100pF; 0603C
C91, C95: 10u; 0603C
C112: 10n, COG; 0402C
D1: D_ACACSOT23; SOT-23; MPN BAV99-7F
L7, L8, L9: 1k/500mA; FB603
L11: 120nH; 0603
R44: 274R; 0603R
R45: 10k; 0603R
R46, R47: 33R,0.5%; 0603R
R48, R49, R50, R51: 1k; 0402R
R52, R53, R55: 2k; 0603R
R54: 100R; 0603R
R56: 1k; 0603R
U3: AD8331; QSOP20; MPN AD8331ARQZ
U4: AD9215BRUZ; TSSOP28; MPN AD9215BRUZ-105
U10: LP3985IM5-3.0; SOT23-5; MPN LP3985IM5X-3.0/NOPB

Connections:
+5VCLEAN: L7.1, L8.1; also elsewhere on the board
ADC_CLK: R54.2, U4.13 (CLK); also elsewhere on the board
ADC_D0: U4.17 (D0); also elsewhere on the board
ADC_D1: U4.18 (D1); also elsewhere on the board
ADC_D2: U4.19 (D2); also elsewhere on the board
ADC_D3: U4.20 (D3); also elsewhere on the board
ADC_D4: U4.21 (D4); also elsewhere on the board
ADC_D5: U4.22 (D5); also elsewhere on the board
ADC_D6: U4.25 (D6); also elsewhere on the board
ADC_D7: U4.26 (D7); also elsewhere on the board
ADC_D8: U4.27 (D8); also elsewhere on the board
ADC_D9: U4.28 (D9); also elsewhere on the board
ADC_OR: U4.1 (OR); also elsewhere on the board
ADC_VCC: C97.1, C98.1, C99.1, C100.1, C111.2, C113.2, R49.2, R51.1, R55.2, U4.7 (AVDD), U4.12 (AVDD), U10.5 (OUT)
ANIN: L11.1; also elsewhere on the board
GND: C69.1, C72.1, C73.1, C74.1, C75.1, C76.1, C77.1, C78.1, C79.1, C80.1, C81.1, C82.1, C83.1, C84.1, C87.1, C88.2, C89.1, C90.1, C93.2, C94.2, C95.1, C96.1, C97.2, C98.2, C99.2, C100.2, C110.1, C111.1, C112.1, C113.1, C114.1, D1.2 (C), R45.1, R48.2, R50.1, R54.1, R56.1, U3.6 (COML), U3.9 (MODE), U3.17 (COMM), U3.20 (COMM), U4.3 (SENSE), U4.8 (AGND), U4.11 (AGND), U4.14 (PDWN), U4.23 (DRGND), U10.2 (GND); also elsewhere on the board
unnamed: C68.1, L11.2
unnamed: C110.2, L9.2, U10.1 (IN), U10.3 (EN)
unnamed: C112.2, U10.4 (BP)
unnamed: C67.2, C68.2, C69.2, U3.2 (INH)
unnamed: C70.2, R44.2, U3.4 (LON)
unnamed: C67.1, R44.1
unnamed: C70.1, U3.8 (VIN)
unnamed: C71.2, U3.5 (LOP)
unnamed: C74.2, C75.2, R45.2, U3.12 (RCLMP)
unnamed: C72.2, C73.2, U3.11 (VCM)
unnamed: C79.2, U3.1 (LMD)
unnamed: C89.2, D1.3 (A), R52.2, U3.10 (GAIN)
unnamed: C80.2, C81.2, C82.2, L8.2, U3.3 (VPSL), U3.18 (ENBV), U3.19 (ENBL)
unnamed: C71.1, U3.7 (VIP)
unnamed: C76.2, C77.2, C78.2, L7.2, U3.14 (VPOS)
unnamed: C87.2, R46.2, R48.1, R49.1, U4.9 (VIN+)
unnamed: C88.1, R47.2, R50.2, R51.2, U4.10 (VIN-)
unnamed: C85.2, U3.15 (VOH)
unnamed: C86.2, U3.16 (VOL)
unnamed: C85.1, R46.1
unnamed: C86.1, R47.1
unnamed: C91.2, C92.2, C93.1, U4.5 (REFB)
unnamed: C91.1, C92.1, C94.1, U4.6 (REFT)
unnamed: C90.2, R52.1, R53.2
unnamed: C95.2, C96.2, U4.4 (VREF)
unnamed: R55.1, R56.2, U4.2 (MODE)
VCCIO: C83.2, C84.2, C114.2, L9.1, U4.24 (DRVDD); also elsewhere on the board
VGA_GAIN: R53.1; also elsewhere on the board
VGA_HILOW: U3.13 (HILO); also elsewhere on the board

Notes on the sheet:
ADC Power Supply V.Reg

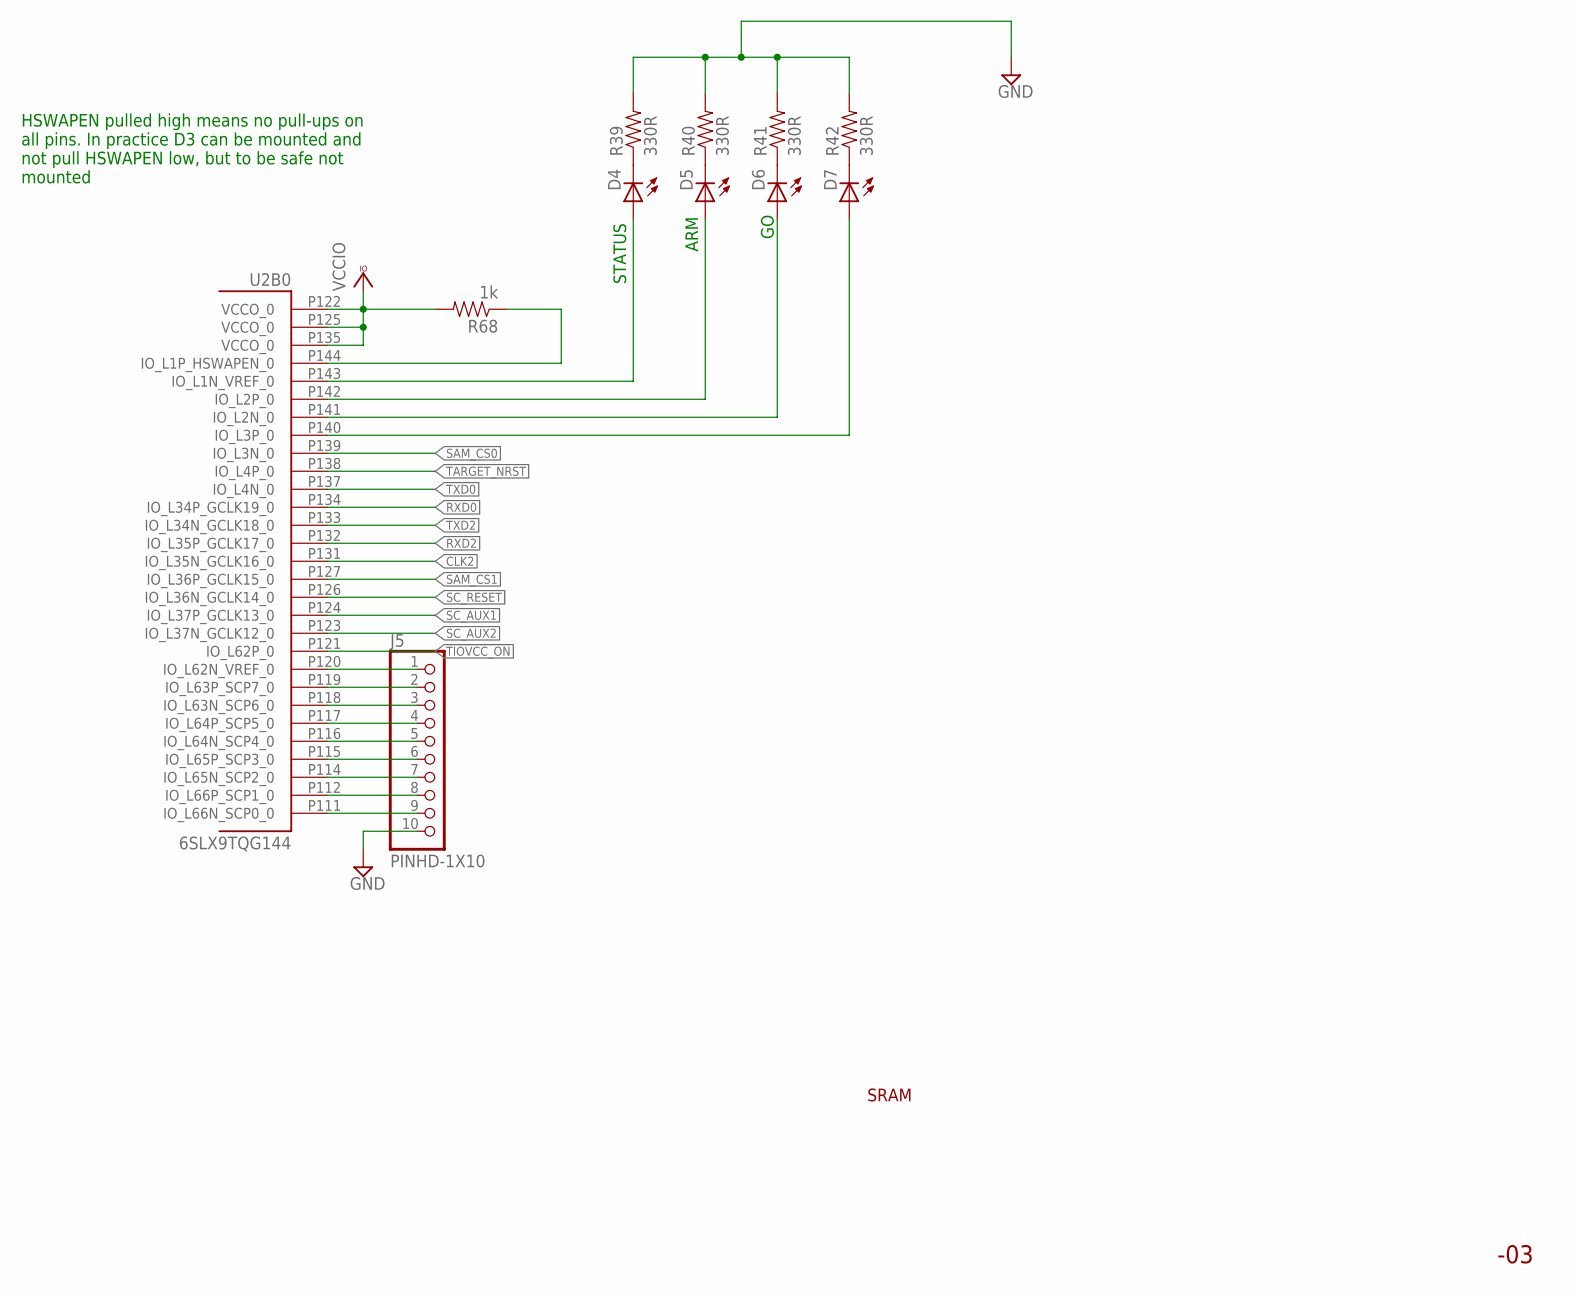
[picture p7: schematic cw-lite-main.sch, sheet 7]

Parts:
D4, D5, D6, D7: LED0603; LED-0603
J5: PINHD-1X10; 1X10-BIG
R39, R40, R41, R42: 330R; 0402R
R68: 1k; 0402R
U2: 6SLX9TQG144; TQ144; MPN XC6SLX9-3TQG144C

Connections:
!TIOVCC_ON: U2.P121 (IO_L62P_0); also elsewhere on the board
CLK2: U2.P131 (IO_L35N_GCLK16_0); also elsewhere on the board
GND: J5.10, R39.2, R40.2, R41.2, R42.2; also elsewhere on the board
LED_ARMED: D6.A, U2.P141 (IO_L2N_0)
LED_CAPTURE: D5.A, U2.P142 (IO_L2P_0)
LED_STATUS: R68.1, U2.P144 (IO_L1P_HSWAPEN_0)
LED_TCLOCK: D7.A, U2.P140 (IO_L3P_0)
LED_USBACT: D4.A, U2.P143 (IO_L1N_VREF_0)
unnamed: J5.1, U2.P120 (IO_L62N_VREF_0)
unnamed: J5.2, U2.P119 (IO_L63P_SCP7_0)
unnamed: J5.3, U2.P118 (IO_L63N_SCP6_0)
unnamed: J5.4, U2.P117 (IO_L64P_SCP5_0)
unnamed: J5.5, U2.P116 (IO_L64N_SCP4_0)
unnamed: J5.6, U2.P115 (IO_L65P_SCP3_0)
unnamed: J5.7, U2.P114 (IO_L65N_SCP2_0)
unnamed: J5.8, U2.P112 (IO_L66P_SCP1_0)
unnamed: J5.9, U2.P111 (IO_L66N_SCP0_0)
unnamed: D4.C, R39.1
unnamed: D5.C, R40.1
unnamed: D6.C, R41.1
unnamed: D7.C, R42.1
RXD0: U2.P134 (IO_L34P_GCLK19_0); also elsewhere on the board
RXD2: U2.P132 (IO_L35P_GCLK17_0); also elsewhere on the board
SAM_CS0: U2.P139 (IO_L3N_0); also elsewhere on the board
SAM_CS1: U2.P127 (IO_L36P_GCLK15_0); also elsewhere on the board
SC_AUX1: U2.P124 (IO_L37P_GCLK13_0); also elsewhere on the board
SC_AUX2: U2.P123 (IO_L37N_GCLK12_0); also elsewhere on the board
SC_RESET: U2.P126 (IO_L36N_GCLK14_0); also elsewhere on the board
TARGET_NRST: U2.P138 (IO_L4P_0); also elsewhere on the board
TXD0: U2.P137 (IO_L4N_0); also elsewhere on the board
TXD2: U2.P133 (IO_L34N_GCLK18_0); also elsewhere on the board
VCCIO: R68.2, U2.P122 (VCCO_0), U2.P125 (VCCO_0), U2.P135 (VCCO_0); also elsewhere on the board

Notes on the sheet:
SRAM
HSWAPEN pulled high means no pull-ups on all pins. In practice D3 can be mounted and not pull HSWAPEN low, but to be safe not mounted
STATUS
ARM
