Lysandr/chipwhisperer/hardware/capture/chipwhisperer-lite/pcb - guillotined/eagle/cw-lite-main.brd

## EAGLE design hardware/capture/chipwhisperer-lite/pcb - guillotined/eagle/cw-lite-main.brd (continued)

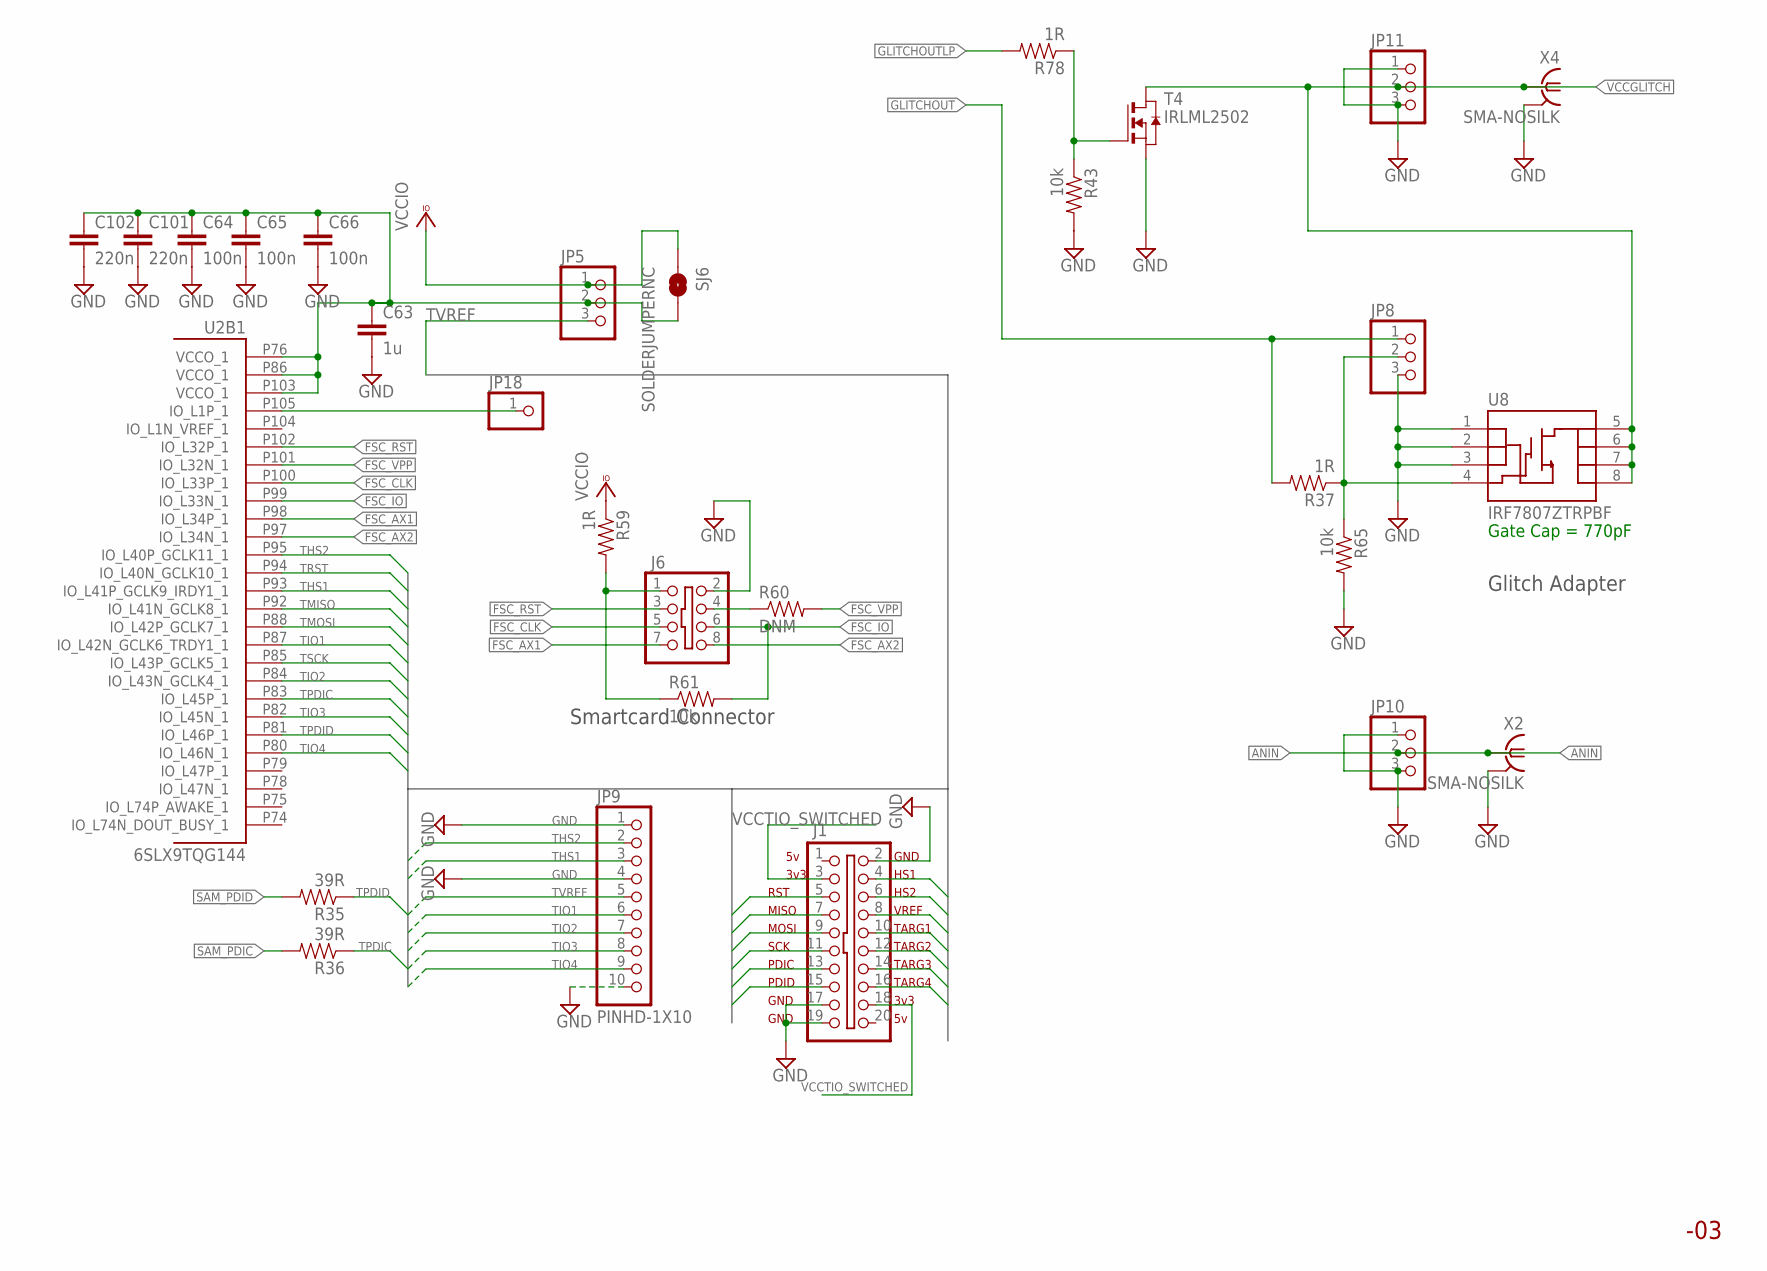
[picture p8: schematic cw-lite-main.sch, sheet 8]

Parts:
C63: 1u; 0603C
C64, C65, C66: 100n; 0402C
C101, C102: 220n; 0402C
J1: SHROUD_2X10-SHROUDED; PINSHRD_PTH_2X10
J6: SHROUD_2X4SHROUD; PINSHRD_PTH_2X04
JP5, JP8, JP10, JP11: PINHD-1X3; 1X03
JP9: PINHD-1X10; 1X10-BIG
JP18: PINHD-1X1; 1X01
R35, R36: 39R; 0603R
R37, R59, R78: 1R; 0603R
R43, R61, R65: 10k; 0603R
R60: DNM; 0603R
SJ6: SOLDERJUMPERNC; SJ_2S
T4: IRLML2502; SOT-23; MPN IRLML2502TRPBF
U2: 6SLX9TQG144; TQ144; MPN XC6SLX9-3TQG144C
U8: IRF7807ZTRPBF; SO08
X2, X4: SMA-NOSILK; J502-ND-142-0711-821/826-NOSILK

Connections:
ANIN: JP10.2, X2.1; also elsewhere on the board
FSC_AX1: J6.7, U2.P98 (IO_L34P_1)
FSC_AX2: J6.8, U2.P97 (IO_L34N_1)
FSC_CLK: J6.5, U2.P100 (IO_L33P_1)
FSC_IO: J6.6, R61.2, U2.P99 (IO_L33N_1)
FSC_RST: J6.3, U2.P102 (IO_L32P_1)
FSC_VPP: R60.2, U2.P101 (IO_L32N_1)
GLITCHOUT: JP8.1, R37.2; also elsewhere on the board
GLITCHOUTLP: R78.2; also elsewhere on the board
GND: C63.2, C64.2, C65.2, C66.2, C101.2, C102.2, J1.2, J1.17, J1.19, J6.2, JP8.3, JP9.1, JP9.4, JP9.10, JP10.1, JP10.3, JP11.1, JP11.3, R43.2, R65.2, T4.2 (S), U8.1 (S), U8.2 (S), U8.3 (S), X2.G@1 (2), X2.G@2 (2), X2.G@3 (2), X2.G@4 (2), X4.G@1 (2), X4.G@2 (2), X4.G@3 (2), X4.G@4 (2); also elsewhere on the board
unnamed: JP8.2, R37.1, R65.1, U8.4 (G)
unnamed: JP18.1, U2.P105 (IO_L1P_1)
unnamed: R43.1, R78.1, T4.3 (G)
unnamed: J6.1, R59.2, R61.1
unnamed: J6.4, R60.1
SAM_PDIC: R36.2; also elsewhere on the board
SAM_PDID: R35.2; also elsewhere on the board
TARGET_VCCIO: C63.1, C64.1, C65.1, C66.1, C101.1, C102.1, JP5.2, SJ6.2, U2.P76 (VCCO_1), U2.P86 (VCCO_1), U2.P103 (VCCO_1)
THS1: J1.4, JP9.3, U2.P93 (IO_L41P_GCLK9_IRDY1_1)
THS2: J1.6, JP9.2, U2.P95 (IO_L40P_GCLK11_1)
TIO1: J1.10, JP9.6, U2.P87 (IO_L42N_GCLK6_TRDY1_1)
TIO2: J1.12, JP9.7, U2.P84 (IO_L43N_GCLK4_1)
TIO3: J1.14, JP9.8, U2.P82 (IO_L45N_1)
TIO4: J1.16, JP9.9, U2.P80 (IO_L46N_1)
TMISO: J1.7, U2.P92 (IO_L41N_GCLK8_1)
TMOSI: J1.9, U2.P88 (IO_L42P_GCLK7_1)
TPDIC: J1.13, R36.1, U2.P83 (IO_L45P_1)
TPDID: J1.15, R35.1, U2.P81 (IO_L46P_1)
TRST: J1.5, U2.P94 (IO_L40N_GCLK10_1)
TSCK: J1.11, U2.P85 (IO_L43P_GCLK5_1)
TVREF: J1.8, JP5.3, JP9.5
VCCGLITCH: JP11.2, T4.1 (D), U8.5 (D), U8.6 (D), U8.7 (D), U8.8 (D), X4.1
VCCIO: JP5.1, R59.1, SJ6.1; also elsewhere on the board
VCCTIO_SWITCHED: J1.3, J1.18; also elsewhere on the board

Notes on the sheet:
HS1
HS2
VREF
TARG1
TARG2
TARG3
TARG4
3v3
RST
MISO
MOSI
SCK
PDIC
PDID
GND
Glitch Adapter
Smartcard Connector
Gate Cap = 770pF

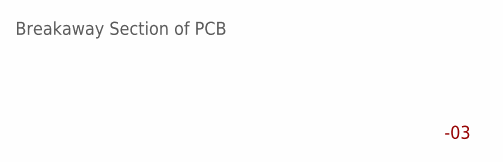
[picture p9: schematic cw-lite-main.sch, sheet 9]

Notes on the sheet:
Breakaway Section of PCB

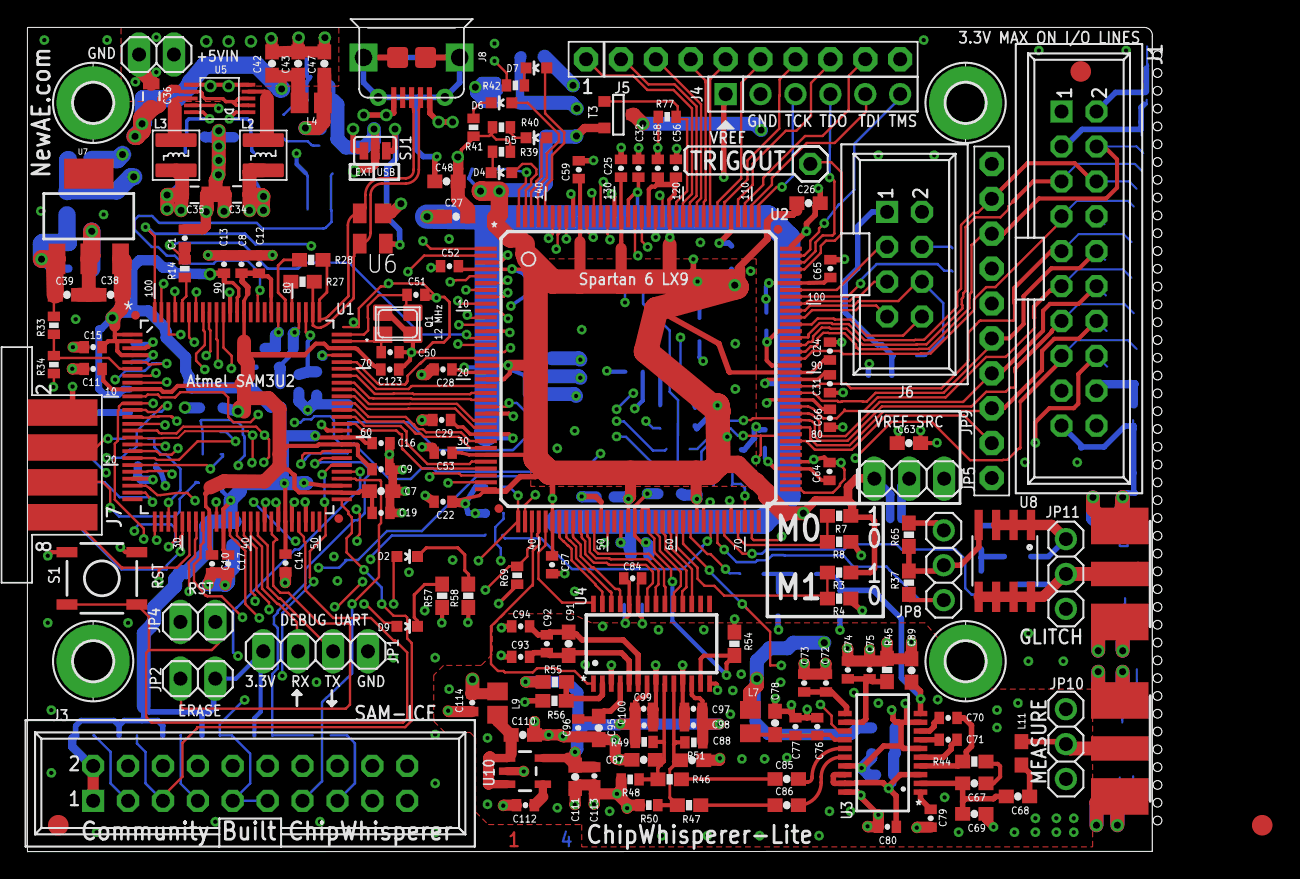
[picture p10: board cw-lite-main.brd from above]

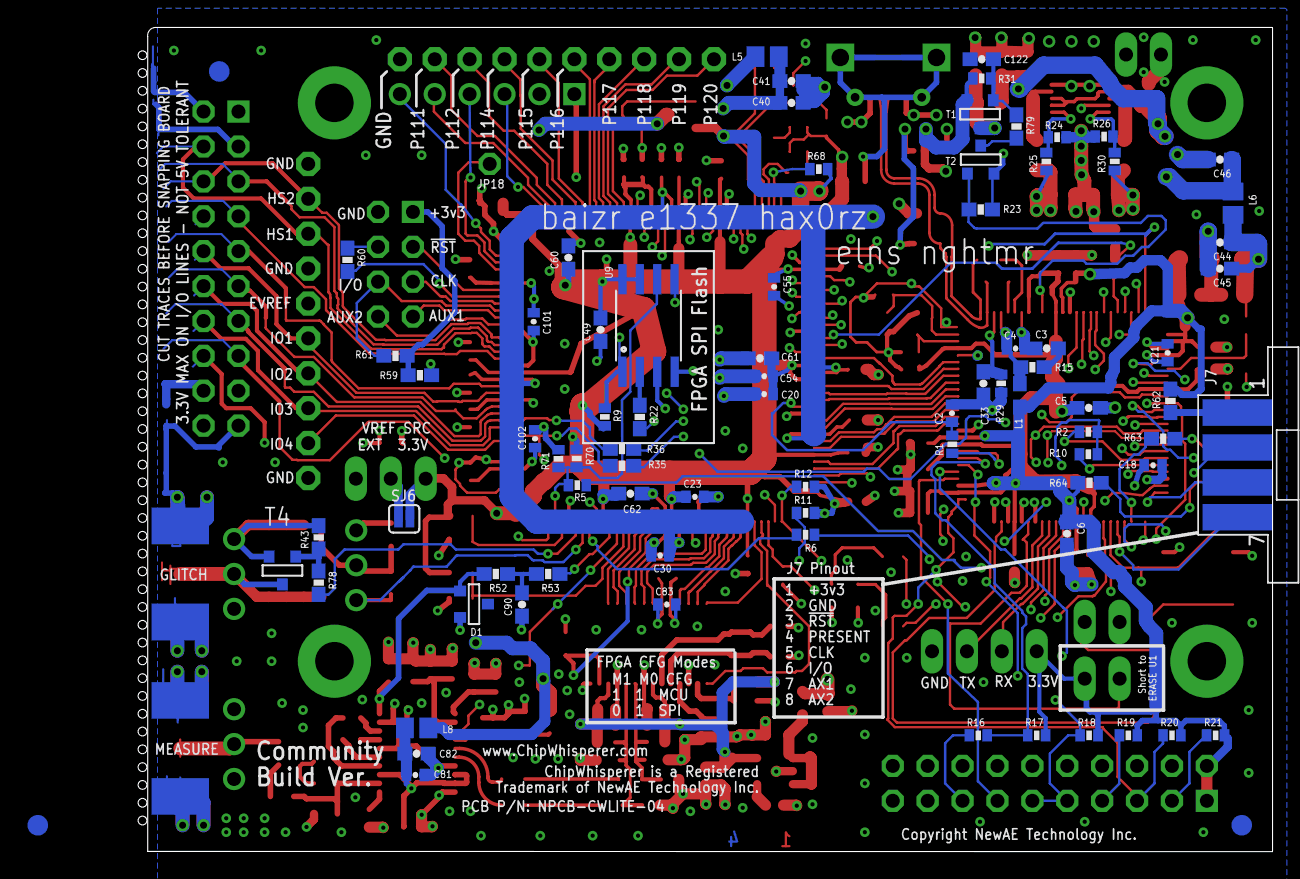
[picture p11: board cw-lite-main.brd from below]

Board: 4 copper layers, 81.9 x 60.0 mm, 245 parts (81 on the bottom side), 198 nets.
