Lysandr/chipwhisperer/(notices)

Notices in the files:
hardware/capture/chipwhisperer-lite/pcb - guillotined/eagle/cw-lite-main.brd:
Copyright NewAE Technology Inc.
parts and their libraries:
SparkFun: Licensing: CC v3.0 Share-Alike You are welcome to use this library for commercial purposes.
SparkFun-PowerIC: Licensing: Creative Commons ShareAlike 4.0 International - https://creativecommons.org/licenses/by-sa/4.0
